barisdinc/ADF7012/README.md

ADF7012
=======

ADF 7012 beacon projesi
