barisdinc/ADF7012/Hardware/beacon7012.pdf

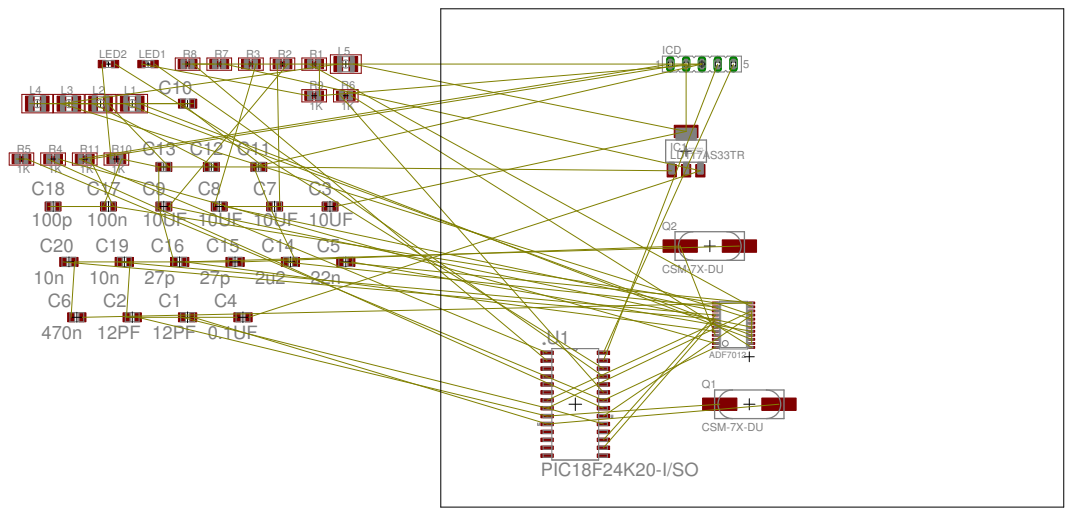
[picture p5: page 1]
