barisdinc/ADF7012/Hardware/beacon7012.brd

## EAGLE design Hardware/beacon7012.brd (2014-03-31)

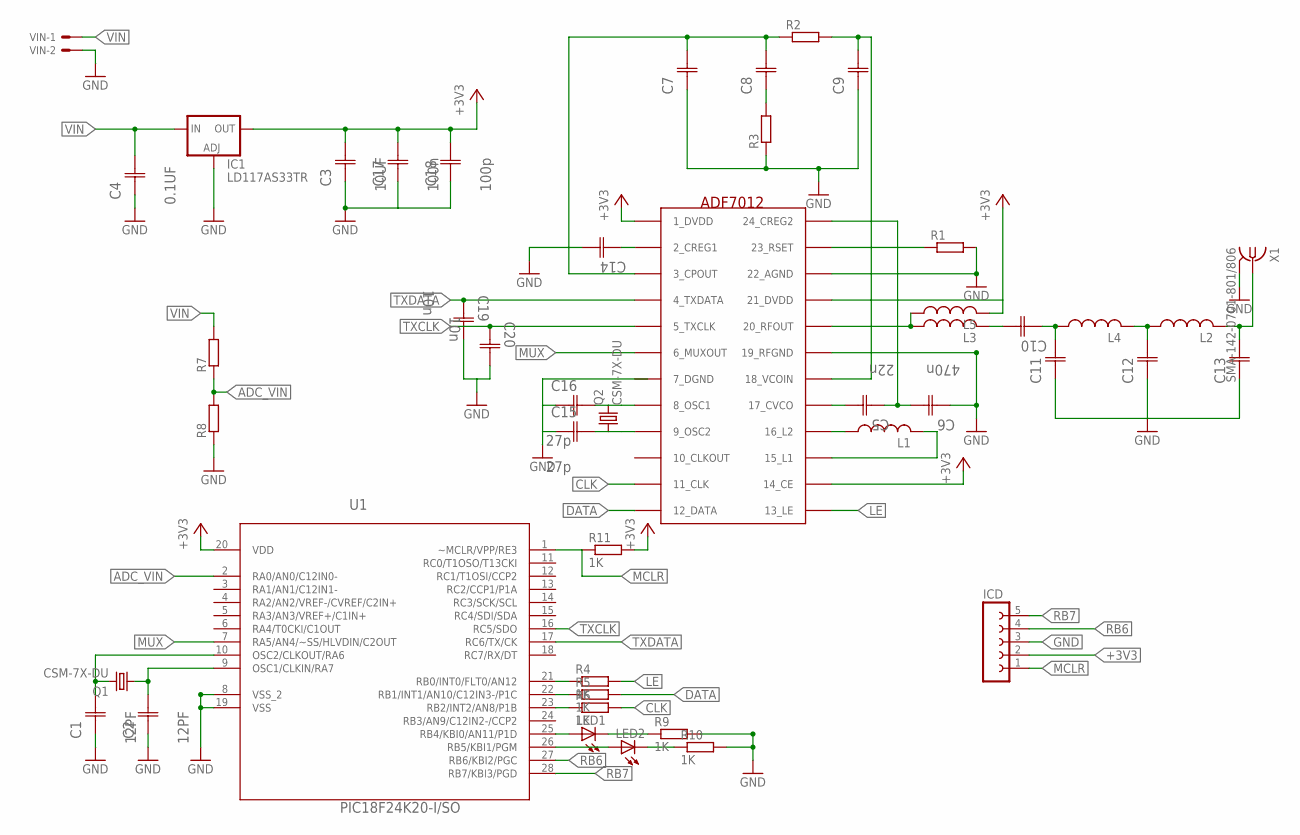
[picture p6: schematic beacon7012.sch, MCU]

Parts:
C1, C2: 12PF; CAPC2012X94N
C3: 10UF; CAPC2013X140N
C4: 0.1UF; CAPC2012X94N
C5: 22n; CAPC2012X94N
C6: 470n; CAPC2012X94N
C7, C8, C9, C11, C12, C13: 0805YD106MAT2A; CAPC2013X140N
C10, C14: 0805ZC104MAT2A; CAPC2012X94N
C15, C16: 27p; CAPC2012X94N
C17: 100n; CAPC2013X140N
C18: 100p; CAPC2013X140N
C19, C20: 10n; CAPC2012X94N
IC1: LD117AS33TR; SOT223
ICD: FE05-1
L1, L2, L3, L4, L5: L-USL2825P; L2825P
LED1, LED2: LEDSML0805; SML0805
Q1, Q2: CSM-7X-DU
R1, R2, R3, R7, R8: R-EU_R0805; R0805
R4, R5, R6, R9, R10, R11: 1K; R0805
U1: PIC18F24K20-I/SO; SOIC127P1030X265-28N
U$1: ADF7012
VIN: KK-156-2
X1: SMA-142-0701-801/806; J502-ND-142-0701-801/806

Connections:
+3V3: C3.2 (C2), C17.2 (C2), C18.2 (C2), IC1.4 (OUT), ICD.2, L5.2, R11.2, U1.20 (VDD), U$1.1_DVDD, U$1.14_CE, U$1.21_DVDD
ADC_VIN: R7.1, R8.2, U1.2 (RA0/AN0/C12IN0-)
CLK: R6.2, U$1.11_CLK
DATA: R5.2, U$1.12_DATA
GND: C1.1 (C1), C2.1 (C1), C3.1 (C1), C4.1 (C1), C6.1 (C1), C7.1 (C1), C9.1 (C1), C11.1 (C1), C12.1 (C1), C13.1 (C1), C14.2 (C2), C15.1 (C1), C16.1 (C1), C17.1 (C1), C18.1 (C1), C19.2 (C2), C20.2 (C2), IC1.1 (ADJ), ICD.3, R1.2, R3.1, R8.1, R9.2, R10.2, U1.8 (VSS_2), U1.19 (VSS), U$1.19_RFGND, U$1.22_AGND, VIN.2, X1.G@1 (2), X1.G@2 (2), X1.G@3 (2), X1.G@4 (2)
LE: R4.2, U$1.13_LE
MCLR: ICD.1, R11.1, U1.1 (~MCLR/VPP/RE3)
MUX: U1.7 (RA5/AN4/~SS/HLVDIN/C2OUT), U$1.6_MUXOUT
unnamed: C1.2 (C2), Q1.2, U1.10 (OSC2/CLKOUT/RA6)
unnamed: C2.2 (C2), Q1.1, U1.9 (OSC1/CLKIN/RA7)
unnamed: R5.1, U1.22 (RB1/INT1/AN10/C12IN3-/P1C)
unnamed: C16.2 (C2), Q2.2, U$1.8_OSC1
unnamed: R1.1, U$1.23_RSET
unnamed: L1.1, U$1.16_L2
unnamed: L1.2, U$1.15_L1
unnamed: C5.2 (C2), U$1.17_CVCO
unnamed: C5.1 (C1), C6.2 (C2), U$1.24_CREG2
unnamed: C7.2 (C2), C8.2 (C2), R2.1, U$1.3_CPOUT
unnamed: C9.2 (C2), R2.2, U$1.18_VCOIN
unnamed: C8.1 (C1), R3.2
unnamed: C12.2 (C2), L2.1, L4.2
unnamed: L3.1, L5.1, U$1.20_RFOUT
unnamed: C10.1 (C1), C11.2 (C2), L4.1
unnamed: C13.2 (C2), L2.2, X1.1
unnamed: C15.2 (C2), Q2.1, U$1.9_OSC2
unnamed: LED1.A, U1.25 (RB4/KBI0/AN11/P1D)
unnamed: C10.2 (C2), L3.2
unnamed: C14.1 (C1), U$1.2_CREG1
unnamed: R6.1, U1.23 (RB2/INT2/AN8/P1B)
unnamed: R4.1, U1.21 (RB0/INT0/FLT0/AN12)
unnamed: LED2.A, U1.26 (RB5/KBI1/PGM)
unnamed: LED1.C, R9.1
unnamed: LED2.C, R10.1
RB6: ICD.4, U1.27 (RB6/KBI2/PGC)
RB7: ICD.5, U1.28 (RB7/KBI3/PGD)
TXCLK: C20.1 (C1), U1.16 (RC5/SDO), U$1.5_TXCLK
TXDATA: C19.1 (C1), U1.17 (RC6/TX/CK), U$1.4_TXDATA
VIN: C4.2 (C2), IC1.3 (IN), R7.2, VIN.1

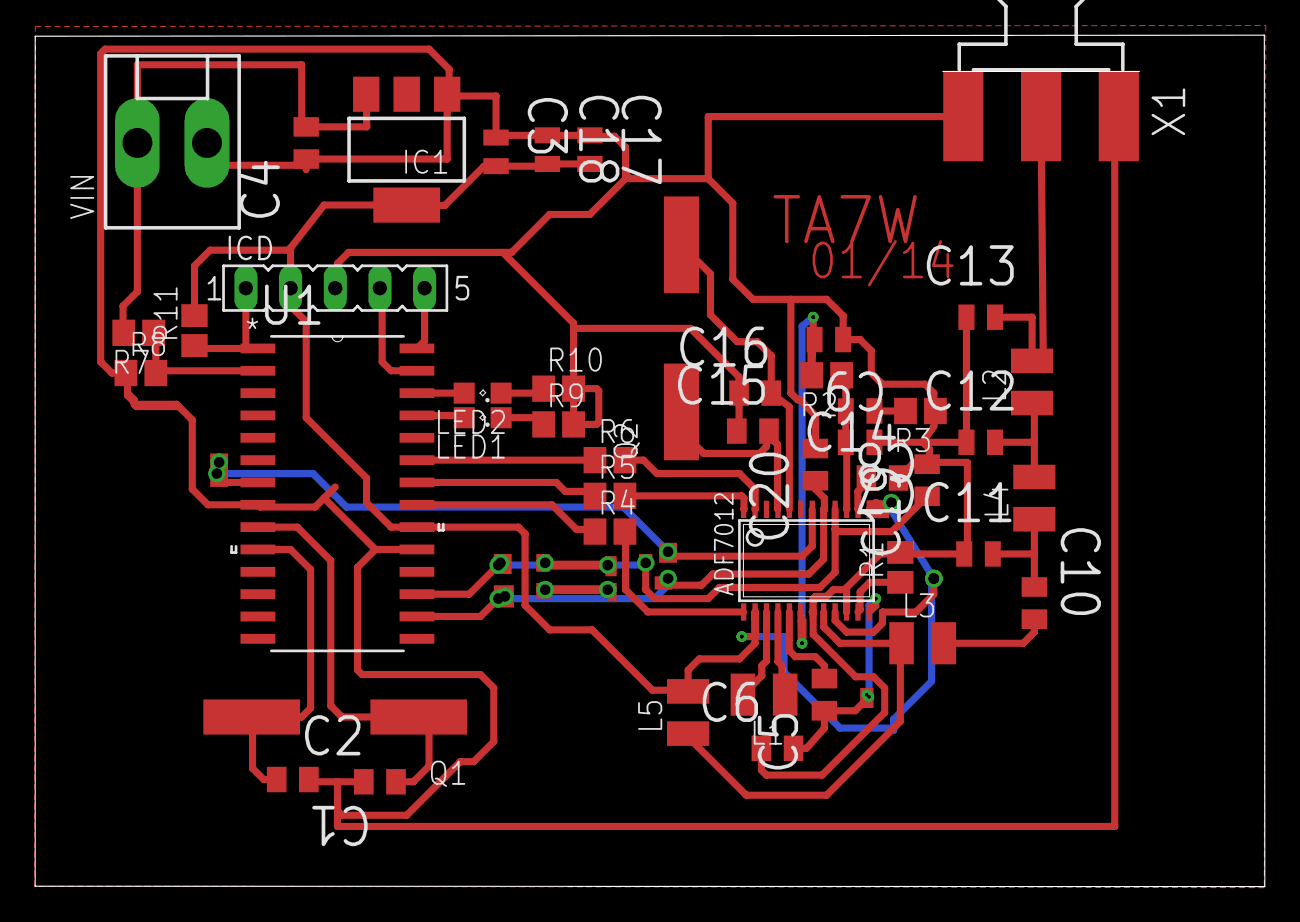
[picture p7: board beacon7012.brd from above]

Board: 2 copper layers, 69.9 x 48.4 mm, 46 parts (0 on the bottom side), 38 nets.
